FoCTow/ToolchangerDevelopment/README.md

# ToolchangerDevelopment
Overengineered 3D Printer Design
