FoCTow/ToolchangerDevelopment/PCB/Render/Back.jpg

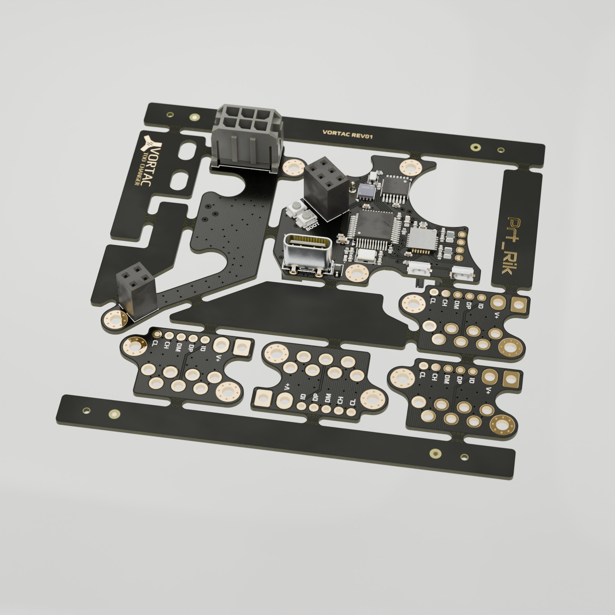
PCB/Render/Back.jpg
