FoCTow/ToolchangerDevelopment/PCB/Render/Front.jpg

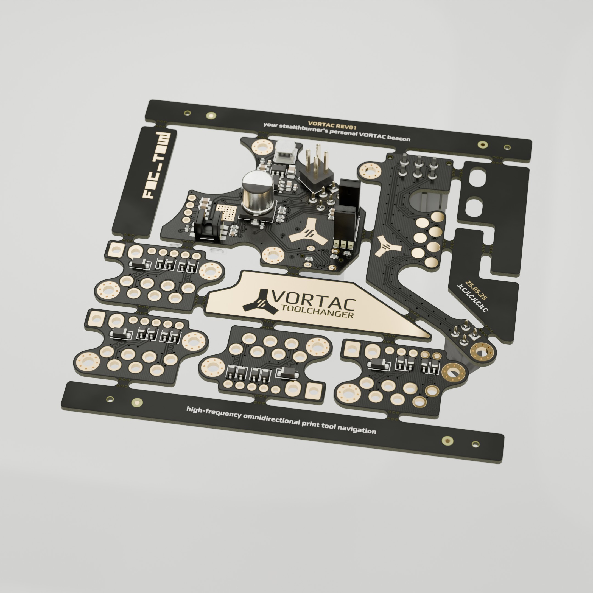
PCB/Render/Front.jpg
