FoCTow/ToolchangerDevelopment/PCB/Vectors/PCB  Main.dxf

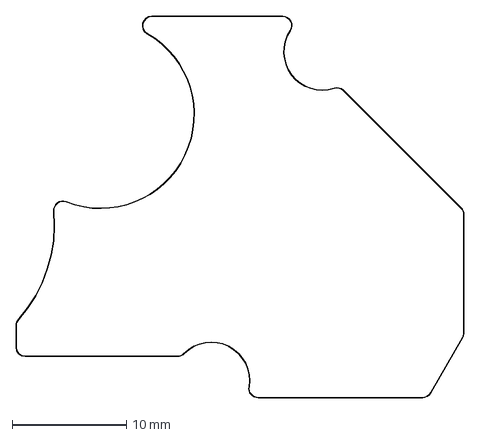
[picture p3: CAD file, 2025-05-24]
PCB/Vectors/PCB Main.dxf
39.2 x 33.4 mm
