FoCTow/ToolchangerDevelopment/PCB/Vectors/Vortac_Toolchanger_Logo.dxf

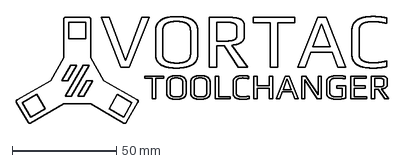
[picture p4: CAD file, 2025-05-25]
PCB/Vectors/Vortac_Toolchanger_Logo.dxf
178.7 x 51.4 mm
