FoCTow/ToolchangerDevelopment/PCB/VORTAC/KiCAD/VORTAC_PANEL/production/Panel_DXF.dxf

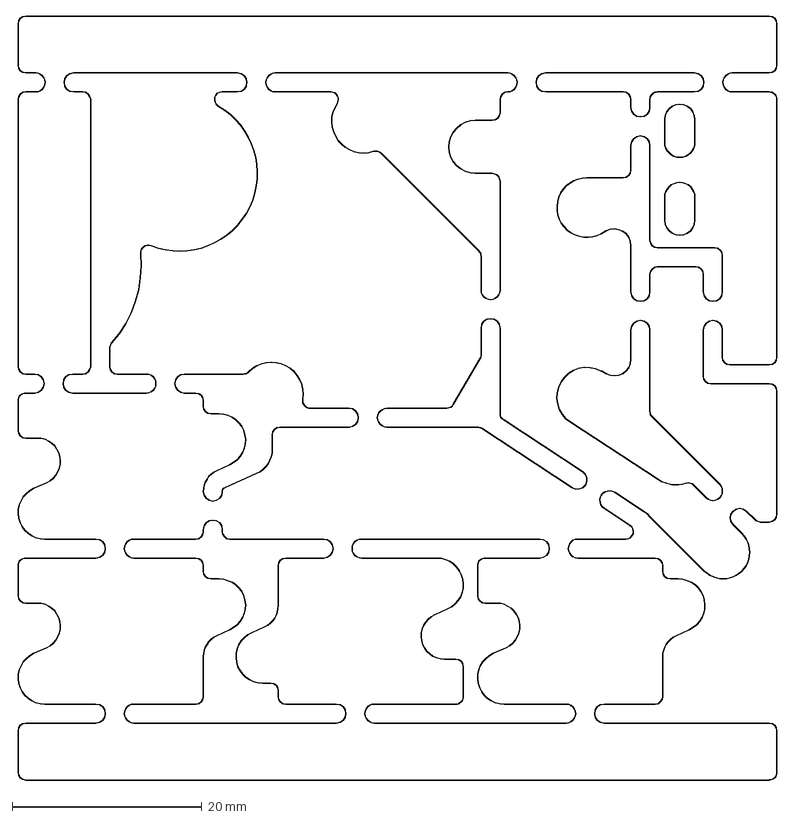
[picture p5: CAD file, 2025-05-25]
PCB/VORTAC/KiCAD/VORTAC_PANEL/production/Panel_DXF.dxf
80.2 x 80.6 mm
