FoCTow/ToolchangerDevelopment/PCB/VORTAC/KiCAD/VORTAC_TOOLPLATE_REV1/VORTAC_TOOLPLATE_REV1/VORTAC_TOOLPLATE_REV1.step

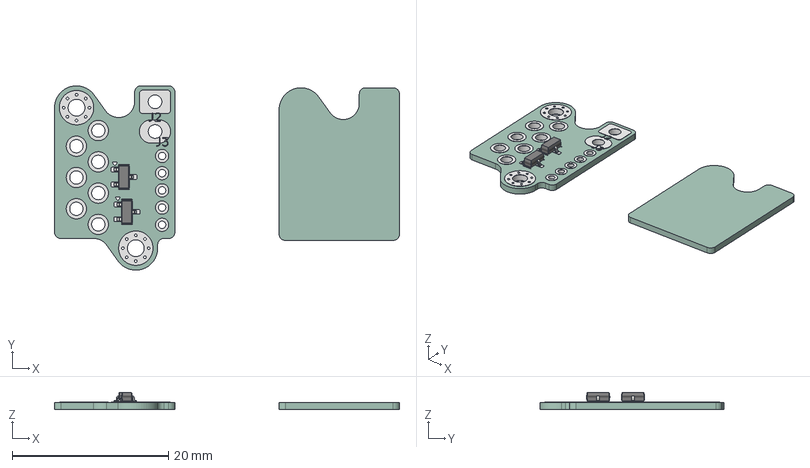
[picture p7: CAD file, 2025-05-24]
PCB/VORTAC/KiCAD/VORTAC_TOOLPLATE_REV1/VORTAC_TOOLPLATE_REV1/VORTAC_TOOLPLATE_REV1.step
44.1 x 23.6 x 2.23 mm
SOT-23 x 2
VORTAC_TOOLPLATE_REV1_pad
VORTAC_TOOLPLATE_REV1_silkscreen
VORTAC_TOOLPLATE_REV1_PCB_1
VORTAC_TOOLPLATE_REV1_PCB_2
