FoCTow/ToolchangerDevelopment/PCB/Vectors/PanelCenter.dxf

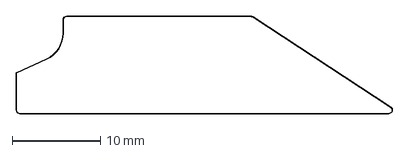
[picture p8: CAD file, 2025-05-25]
PCB/Vectors/PanelCenter.dxf
42.6 x 11.0 mm
