FoCTow/ToolchangerDevelopment/PCB/VORTAC/KiCAD/VORTAC_PANEL/production/Vortac_Panel_Rev1ToolBoardOnly.step

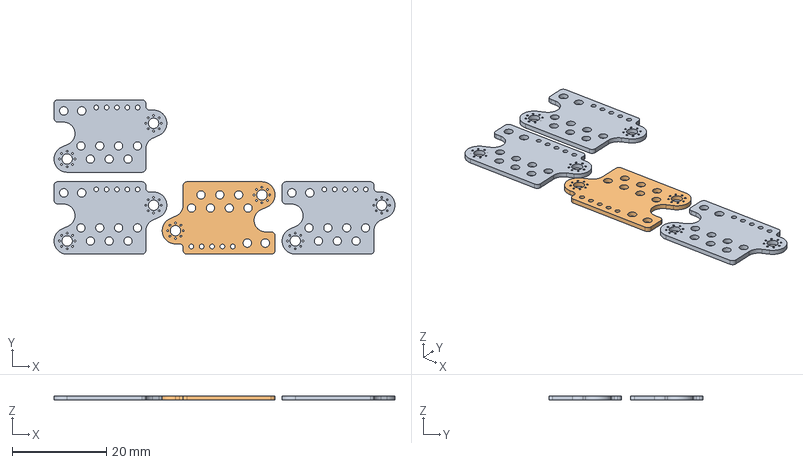
[picture p9: CAD file, 2025-05-25]
PCB/VORTAC/KiCAD/VORTAC_PANEL/production/Vortac_Panel_Rev1ToolBoardOnly.step
72.4 x 32.8 x 0.91 mm
Vortac_Panel_PCB_1
Vortac_Panel_PCB_2
Vortac_Panel_PCB_3
Vortac_Panel_PCB_4
