FoCTow/ToolchangerDevelopment/PCB/Vectors/PCB Tool.dxf

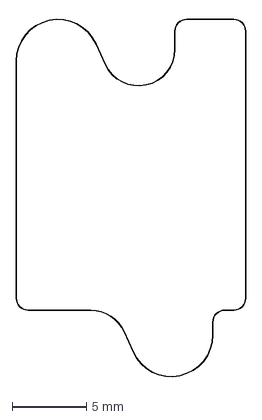
[picture p10: CAD file, 2025-05-24]
PCB/Vectors/PCB Tool.dxf
15.4 x 24.4 mm
