FoCTow/ToolchangerDevelopment/PCB/VORTAC/KiCAD/VORTAC_PANEL/production/Vortac_Panel_Rev1BoardOnly.step

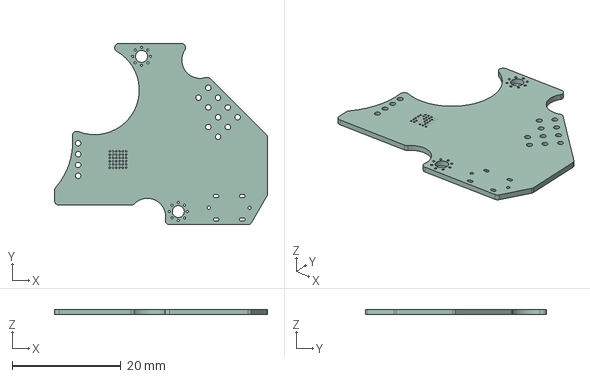
[picture p11: CAD file, 2025-05-25]
PCB/VORTAC/KiCAD/VORTAC_PANEL/production/Vortac_Panel_Rev1BoardOnly.step
39.2 x 33.4 x 0.91 mm
