FoCTow/ToolchangerDevelopment/PCB/VORTAC/KiCAD/VORTAC_PANEL/production/Vortac_Panel_TestPanel.step

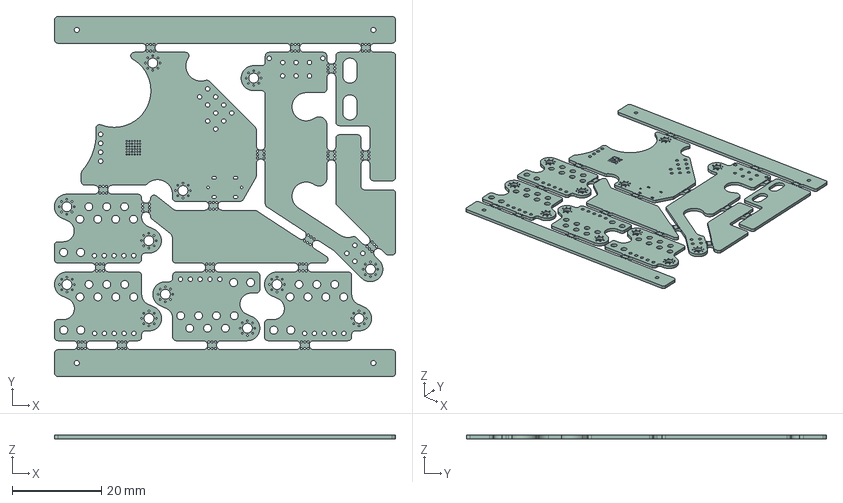
[picture p12: CAD file, 2025-05-25]
PCB/VORTAC/KiCAD/VORTAC_PANEL/production/Vortac_Panel_TestPanel.step
76.4 x 80.6 x 0.91 mm
