FoCTow/ToolchangerDevelopment/PCB/Vectors/PCB Front.dxf

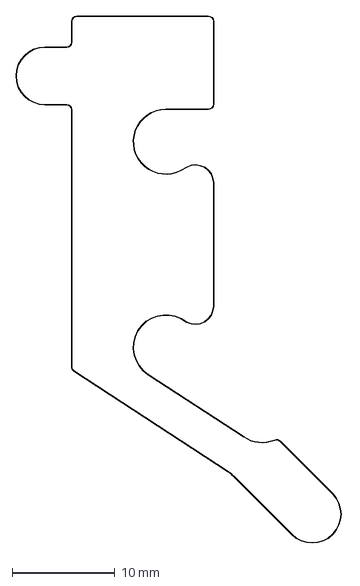
[picture p13: CAD file, 2025-05-24]
PCB/Vectors/PCB Front.dxf
31.9 x 51.5 mm
