FoCTow/ToolchangerDevelopment/PCB/VORTAC/KiCAD/VORTAC_PANEL/production/Vortac_Panel_export.step

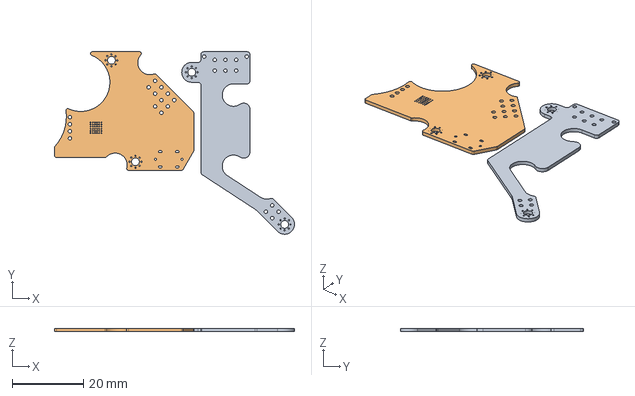
[picture p14: CAD file, 2025-05-23]
PCB/VORTAC/KiCAD/VORTAC_PANEL/production/Vortac_Panel_export.step
67.5 x 51.3 x 0.91 mm
Vortac_Panel_PCB_1
Vortac_Panel_PCB_2
