FoCTow/ToolchangerDevelopment/PCB/Vectors/PCB Clearance.dxf

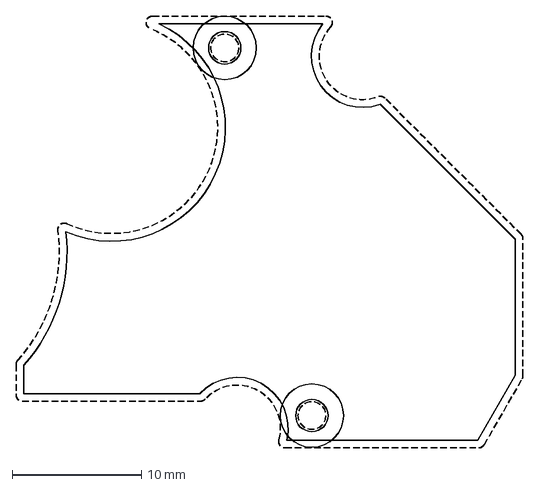
[picture p15: CAD file, 2025-05-21]
PCB/Vectors/PCB Clearance.dxf
39.2 x 33.4 mm
