FoCTow/ToolchangerDevelopment/(threads)

Thread 2 (2025-06-10):

Grabber PCB is missing 1.5K pullup on USB D+

FoCTow, 2025-06-10:
A 1.5K pull on usb d+ seems to be required to signal device connection, device speed and trigger address assignment.
The STM32f103 doesnt feature this internally so a 1.5K pullup on usb d+ is mandatory

Thread 3 (2025-06-10):

PCB power planes should have more edge clearance

FoCTow, 2025-06-10:
The Grabber PCB especially sits very close to the motors metal housing meaning a potential short could occur on the pcbs edge should printing tolerance expose the power plane to the side.
To remedy this the power planes edge clearance should be increased.
