FoCTow/ToolchangerDevelopment/PCB/VORTAC/KiCAD/VORTAC_TOOLPLATE_REV1/VORTAC_TOOLPLATE_REV1/VORTAC_TOOLPLATE_REV1.kicad_pcb

## KiCad design PCB/VORTAC/KiCAD/VORTAC_TOOLPLATE_REV1/VORTAC_TOOLPLATE_REV1/VORTAC_TOOLPLATE_REV1.kicad_pcb (2025-05-25)

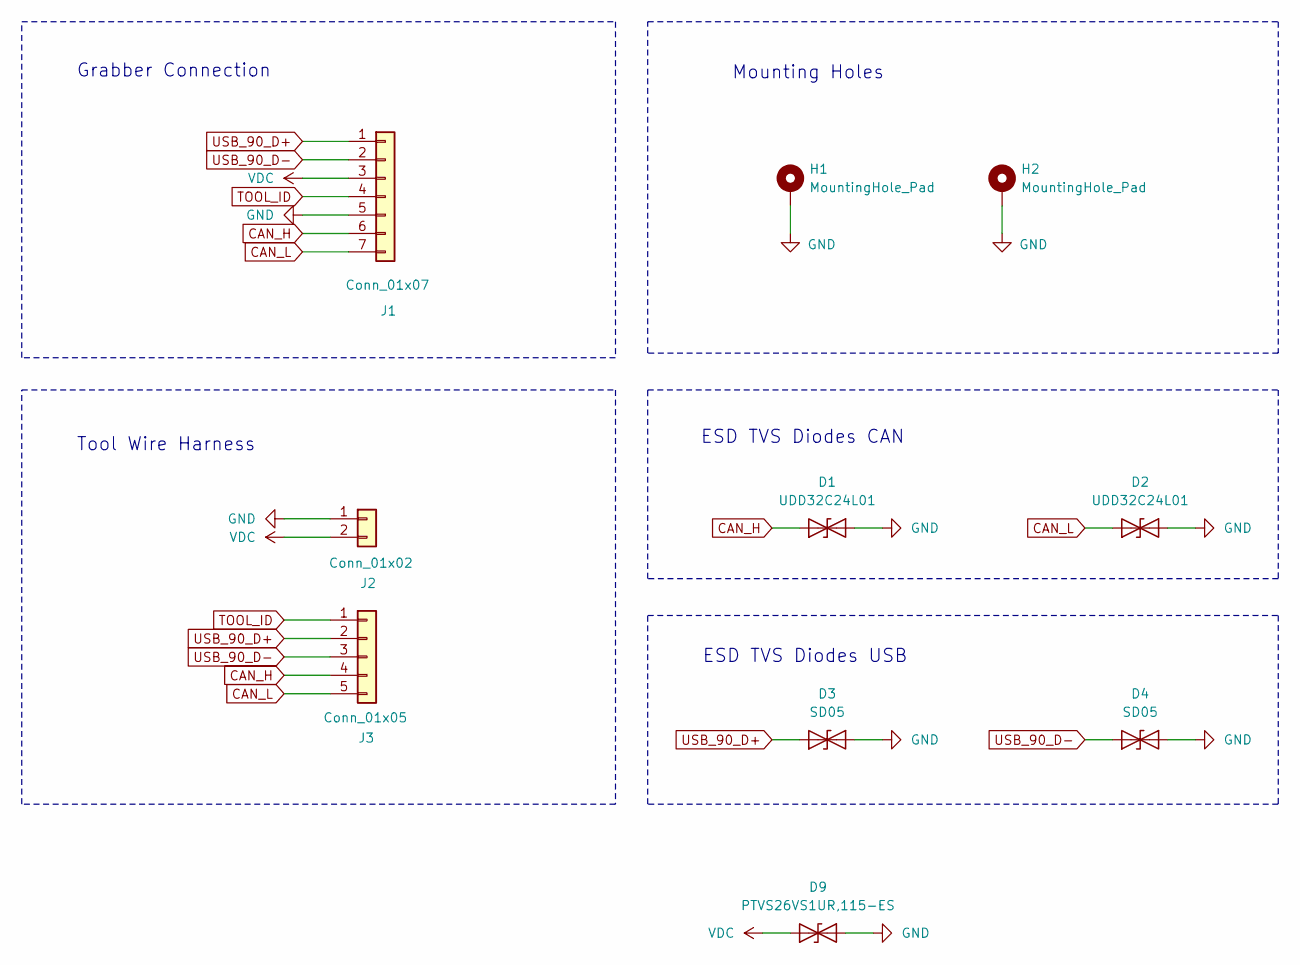
[picture p24: schematic VORTAC_TOOLPLATE_REV1.kicad_sch]

Parts:
D1, D2: UDD32C24L01; D_SOD-323; LCSC C19188728
D3, D4: SD05; D_SOD-323; LCSC C502527
D9: PTVS26VS1UR,115-ES; D_SOD-123F; LCSC C41409305
H1, H2: MountingHole_Pad; MountingHole_2.2mm_M2_Pad_Via_NTR
J1: Conn_01x07; mill-max-0881-1-15-20-82-14-11-0_LandingPads_ContactPad_PTH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
J2: Conn_01x02; Toolplate_Solderpoint_01x02_Power
J3: Conn_01x05; Toolplate_Solderpoint_01x05_Data

Connections:
CAN_H: D1.2 (A2), J1.6, J3.4
CAN_L: D2.2 (A2), J1.7, J3.5
GND: D1.1 (A1), D2.1 (A1), D3.1 (A1), D4.1 (A1), D9.1 (A1), H1.1, H2.1, J1.5, J2.1
TOOL_ID: J1.4, J3.1
USB_90_D+: D3.2 (A2), J1.1, J3.2
USB_90_D-: D4.2 (A2), J1.2, J3.3
VDC: D9.2 (A2), J1.3, J2.2

Notes on the sheet:
Grabber Connection
Tool Wire Harness
ESD TVS Diodes CAN
ESD TVS Diodes USB
Mounting Holes

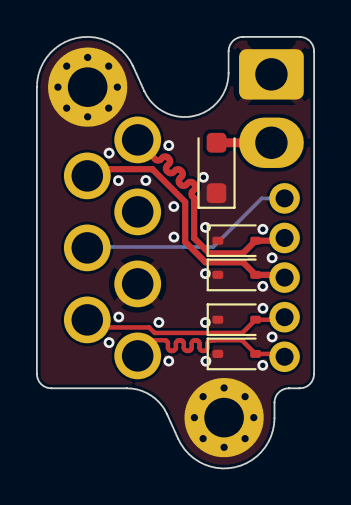
[picture p25: board VORTAC_TOOLPLATE_REV1.kicad_pcb from above]

Board: 4 copper layers, 15.4 x 24.0 mm, 10 parts (0 on the bottom side), 7 nets.
