FoCTow/ToolchangerDevelopment/PCB/VORTAC/KiCAD/VORTAC/VORTAC.kicad_pcb

## KiCad design PCB/VORTAC/KiCAD/VORTAC/VORTAC.kicad_pcb (2022-12-05, an earlier design)

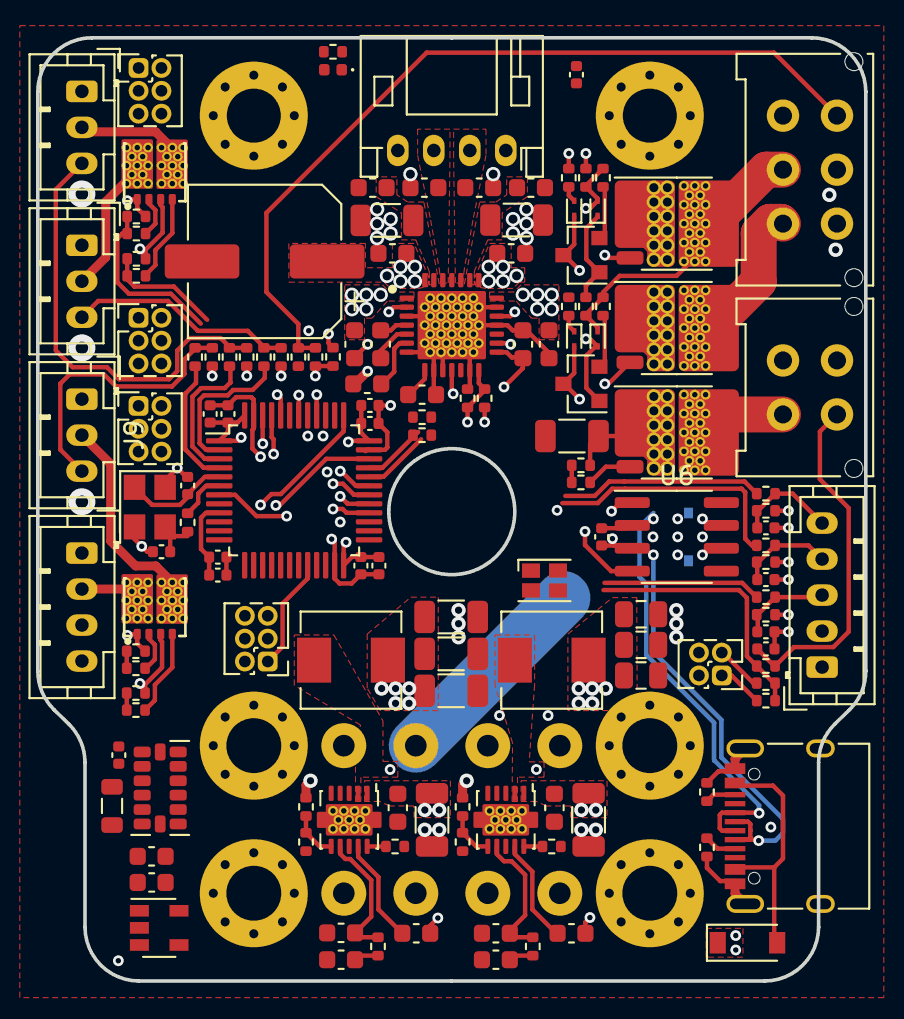
[picture p26: board VORTAC.kicad_pcb from above]

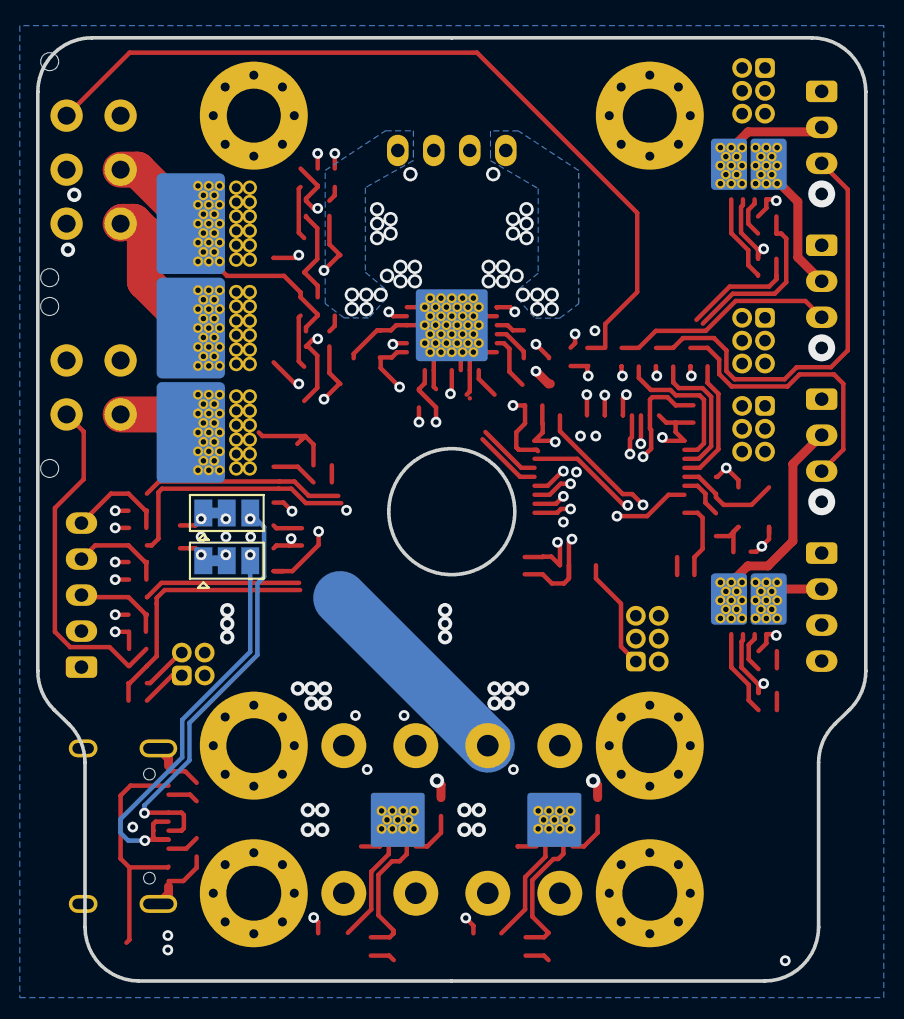
[picture p27: board VORTAC.kicad_pcb from below]

Board: 4 copper layers, 46.0 x 52.4 mm, 146 parts (4 on the bottom side), 107 nets.

Parts:
C1, C4, C5: 10uF 50V; C_1206_3216Metric
C2, C33, C35, C36, C37, C38, C39, C46, C47, C48, C49: 0.1uF 16V; C_0402_1005Metric
C3, C8: 1uF; C_0603_1608Metric
C6, C7, C9, C11, C21, C22, C24, C26, C29, C31, C41: 0.1uF 50V; C_0603_1608Metric
C10: 360pF; C_0603_1608Metric
C12: 3.3nF; C_0603_1608Metric
C13: 30pF; C_0603_1608Metric
C14: 56pF; C_0603_1608Metric
C15, C17, C19: 47uF; C_1206_3216Metric
C16, C18, C20: 47uF; C_0805_2012Metric
C23: 22nF X7R 10% 50V; C_0603_1608Metric
C25, C27, C28, C30: 470pF 100V; C_0603_1608Metric
C32, C40: 4.7uF 10V; C_0402_1005Metric
C34: 100uF 35V; CP_Elec_8x6.9
C42, C43: C_Small; C_0402_1005Metric
C44: 10nF; C_0402_1005Metric
C45: 1uF; C_0402_1005Metric
D1, D2, D3, D4: D; D_SOD-923
D5: D_Schottky; D_SOD-123
D6: LED_Small; LED_0402_1005Metric
D7: NeoPixel_THT; LED_Cree-PLCC4_2x2mm_CW
H1, H2: M3; MountingHole_3mm_Pad_Via
HSE1: 8MHz; Crystal_SMD_3225-4Pin_3.2x2.5mm
IC1: TMC2209-LA; tmc_2209_ThermalPad
J1: DEBUG; PinHeader_2x03_P1.27mm_Vertical
J2: Molex Micro Fit 3.0; Molex_Micro-Fit_3.0_43045-0612_2x03_P3.00mm_Vertical
J3, J4: MillMax_004; MillMax-858-10-004-10-012000
J5: USB_HOST; JST_PH_B4B-PH-K_1x04_P2.00mm_Vertical
J6: HOTEND; Molex_Micro-Fit_3.0_43045-0412_2x02_P3.00mm_Vertical
J7: FAN_01; JST_PH_B3B-PH-K_1x03_P2.00mm_Vertical
J8: FAN_02; JST_PH_B3B-PH-K_1x03_P2.00mm_Vertical
J9: LED; JST_PH_B3B-PH-K_1x03_P2.00mm_Vertical
J10: FAN_01_V; PinHeader_2x03_P1.27mm_Vertical
J11: FAN_02_V; PinHeader_2x03_P1.27mm_Vertical
J12: LED_V; PinHeader_2x03_P1.27mm_Vertical
J13: THERM_R; PinHeader_2x02_P1.27mm_Vertical
J14: 918-418K2023S40001; USB_C_Receptacle_XKB_U262-16XN-4BVC11
J15: STEPPER; JST_PH_S4B-PH-K_1x04_P2.00mm_Horizontal
J16: IO; JST_PH_B5B-PH-K_1x05_P2.00mm_Vertical
JP1: DATA_H JUMPER; SolderJumper-3_P1.3mm_Bridged12_Pad1.0x1.5mm
JP2: DATA_L JUMPER; SolderJumper-3_P1.3mm_Bridged12_Pad1.0x1.5mm
L1, L2: 10uH; L_Sunlord_MWSA0518_5.4x5.2mm
L3: 10uH 15mA; L_0805_2012Metric
Q1: Q_PMOS_GSD; IRF9310PbF-1_SO-8_ThermalPad
Q2, Q4: Q_NMOS_GSD; IRF9310PbF-1_SO-8_ThermalPad
Q3, Q5: WSD4066DN; WSD4066DN_ThermalPad
Q6: Q_PNP_BEC; SOT-23
Q7: Q_NPN_BEC; SOT-23
R1: 1K .1%; R_0402_1005Metric
R2: 4.7K .1%; R_0402_1005Metric
R3, R4: 5.12K; R_0402_1005Metric
R5, R6, R17, R18, R19, R20: 100K; R_0402_1005Metric
R7, R8, R9, R10, R11: 100R; R_0402_1005Metric
R12, R13, R14, R15, R16, R21, R39, R40, R41, R42, R43, R44, R45, R46, R47, R48, R49, R50, R51, R52: 10K; R_0402_1005Metric
R22: 36.5k; R_0402_1005Metric
R23: 10k; R_0402_1005Metric
R24, R25: 95k; R_0402_1005Metric
R26, R28: 100k; R_0402_1005Metric
R27: 7.15k; R_0402_1005Metric
R29: 19.1k; R_0402_1005Metric
R30, R34: 0.1R 1%; R_1206_3216Metric
R31: 1K; R_0402_1005Metric
R32, R33: 22K; R_0402_1005Metric
R35, R36: 22R; R_0402_1005Metric
R37, R38: R_Small; R_0402_1005Metric
U1: TLV73333PDBV; SOT-23-5
U2: STM32F103C8Tx; LQFP-48_7x7mm_P0.5mm
U3, U4: TPS54335ADRCR; VSON-10-1EP_3x3mm_P0.5mm_EP1.65x2.4mm_ThermalVias
U5: ADXL345BCCZ-RL; LGA-14_3x5mm_P0.8mm_LayoutBorder1x6y
U6: SN65HVD232DR; SOIC-8_3.9x4.9mm_P1.27mm

Connections:
+3.3VA: C44.1, C45.1, J13.2, J13.4, L3.2, U2.9
+3V3: C8.1, C21.1, C32.1, C33.2, C35.1, C36.2, C37.2, C38.2, C39.2, C40.2, IC1.15, J1.2, L3.1, R32.2, R45.1, R46.1, R47.1, R48.1, R49.1, R50.1, R52.1, U1.5, U2.1, U2.24, U2.36, U2.48, U5.1, U5.6, U6.3
+5V: C3.1, C16.1, C18.1, C20.1, D5.1, J5.1, J10.5, J11.5, J12.5, J16.1, L2.2, R28.1, U1.1, U1.3
+12V: C15.1, C17.1, C19.1, J10.3, J11.3, J12.3, L1.2, R26.1
ADXL_CS: U2.14, U5.7
ADXL_INT1: U2.13, U5.8
ADXL_SCL: U2.15, U5.14
ADXL_SDI: U2.17, U5.13
ADXL_SDO: U2.16, U5.12
BOOT_1: J1.1, U2.20
CAN_H: JP1.1, U6.7
CAN_L: JP2.1, U6.6
CAN_RX: U2.45, U6.4
CAN_TX: U2.46, U6.1
DEBUG_SWCLK: J1.6, U2.37
DEBUG_SWDIO: J1.5, U2.34
DOCK_GND: D4.2, J2.1, Q2.3, R18.2, R19.2
DOCK_VDC: D3.1, J2.2, Q1.3, R17.1, R20.1
FAN_1_DRAIN: J7.2, Q5.6
FAN_1_GATE: R10.2, R15.2, U2.42
FAN_1_TACHO: J7.3, R39.2, R45.2
FAN_1_V_OUT: J7.1, J10.2, J10.4, J10.6
FAN_2_DRAIN: J8.2, Q5.5
FAN_2_GATE: R9.2, R14.2, U2.43
FAN_2_TACHO: J8.3, R40.2, R46.2
FAN_2_V_OUT: J8.1, J11.2, J11.4, J11.6
GND: C1.2, C2.2, C3.2, C4.2, C5.2, C6.2, C7.2, C8.2, C10.2, C12.2, C13.2, C14.2, C15.2, C16.2, C17.2, C18.2, C19.2, C20.2, C21.2, C22.2, C25.1, C26.1, C27.1, C28.1, C29.1, C30.1, C31.1, C32.2, C33.1, C34.2, C35.2, C36.1, C37.1, C38.1, C39.1, C40.1, C41.1, C44.2, C45.2, C46.1, C47.1, C48.1, C49.1, D6.1, H1.1, H2.1, IC1.3, IC1.7, IC1.9, IC1.10, IC1.13, IC1.18, IC1.20, IC1.29, J1.4, J2.3, J3.1, J3.2, J4.1, J6.4, J14.A1, J14.A12, J14.B1, J14.B12, J14.S1, J16.2, Q2.2, Q3.1, Q3.3, Q4.2, Q5.1, Q5.3, R3.1, R4.1, R6.2, R12.1, R13.1, R14.1, R15.1, R16.1, R24.1, R25.1, R27.2, R29.2, R30.1, R33.2, R34.1, U1.2, U2.8, U2.23, U2.35, U2.47, U3.3, U3.4, U3.5, U3.11, U4.3, U4.4, U4.5, U4.11, U5.2, U5.4, U5.5, U6.2, U6.5, U6.8
GND1: C42.2, C43.2, HSE1.2, HSE1.4
HEATER_DRAIN: J6.1, Q4.3
HEATER_GATE: R11.2, R16.2, U2.27
HOST_USB_D+: J4.3, J5.3
HOST_USB_D-: J4.2, J5.4
HOST_USB_DRAIN: J5.2, Q3.5
HOST_USB_GATE: R7.2, R12.2, U2.10
HSE_OSC_IN: C42.1, HSE1.1, U2.5
HSE_OSC_OUT: R37.2, U2.6
IO_1_OUT: C46.2, J16.5, R42.2, R48.2
IO_1_OUT_PIN: R42.1, U2.26
IO_2_OUT: C47.2, J16.4, R43.2, R49.2
IO_2_OUT_PIN: R43.1, U2.25
IO_3_OUT: C48.2, J16.3, R44.2, R50.2
IO_3_OUT_PIN: R44.1, U2.22
LED_0: R38.2, U2.2
LED_1_DRAIN: J9.2, Q3.6
LED_1_GATE: R8.2, R13.2, U2.11
LED_1_PWM: J9.3, R41.2, R47.2
LED_1_V_OUT: J9.1, J12.2, J12.4, J12.6
NRST: J1.3, U2.7
unnamed: C9.1, L1.1, U3.2
unnamed: C9.2, U3.9
unnamed: C10.1, R22.2, U3.7
unnamed: C11.1, L2.1, U4.2
unnamed: C11.2, U4.9
unnamed: C12.1, R23.2, U4.7
unnamed: C13.1, R22.1
unnamed: C14.1, R23.1
unnamed: C22.1, IC1.8
unnamed: C23.1, IC1.5
unnamed: C23.2, IC1.4
unnamed: C24.1, IC1.6
unnamed: C43.1, HSE1.3, R37.1
unnamed: D1.1, Q1.1, Q7.3
unnamed: D1.2, R5.2
unnamed: D2.1, R6.1
unnamed: D2.2, Q2.1, Q6.3
unnamed: D3.2, Q6.1, R18.1
unnamed: D4.1, Q7.1, R20.2
unnamed: D5.2, J14.A4, J14.A9, J14.B4, J14.B9
unnamed: D6.2, R38.1
unnamed: J13.1, R1.1
unnamed: J13.3, R2.1
unnamed: J14.A5, R4.2
unnamed: J14.B5, R3.2
unnamed: Q3.2, R7.1
unnamed: Q3.4, R8.1
unnamed: Q4.1, R11.1
unnamed: Q5.2, R9.1
unnamed: Q5.4, R10.1
unnamed: Q6.2, R17.2
unnamed: Q7.2, R19.1
unnamed: R24.2, U3.10
unnamed: R25.2, U4.10
unnamed: R26.2, R27.1, U3.6
unnamed: R28.2, R29.1, U4.6
unnamed: R35.2, U2.32
unnamed: R36.2, U2.33
STEP_1_A1: C28.2, IC1.24, J15.2
STEP_1_A2: C30.2, IC1.21, J15.1
STEP_1_B1: C27.2, IC1.26, J15.3
STEP_1_B2: C25.2, IC1.1, J15.4
THERM_1_OUT: C2.1, J6.3, R21.1
THERM_1_PIN: R1.2, R2.2, R21.2, U2.21
TMC_BRA: C41.2, IC1.23, R34.2
TMC_BRB: C31.2, IC1.27, R30.2
TMC_DIAG: IC1.11, U2.38
TMC_DIR: IC1.19, U2.29
TMC_ENN: IC1.2, R32.1, U2.40
TMC_STEP: IC1.16, U2.28
TMC_UART_RX: IC1.14, R31.2, R33.1, U2.31
TMC_UART_TX: R31.1, U2.30
TOOL_DATA_H: J2.5, J3.4, JP1.2
TOOL_DATA_L: J2.4, J3.5, JP2.2
TOOL_ID: C49.2, J2.6, J4.4, R51.2, R52.2
TOOL_ID_PIN: R51.1, U2.41
USB_D+: J14.A6, J14.B6, JP1.3, R36.1
USB_D-: J14.A7, J14.B7, JP2.3, R35.1
VDC: C1.1, C4.1, C5.1, C6.1, C7.1, C24.2, C26.2, C29.2, C34.1, IC1.22, IC1.28, J3.3, J6.2, J10.1, J11.1, J12.1, Q1.2, R5.1, U3.1, U4.1
