FoCTow/ToolchangerDevelopment/PCB/STM32CubeMX/STM32CubeMX.ioc

Mcu.UserName=STM32F103C8Tx
PA0-WKUP.GPIO_Label=GPIO_OUT_TMC_ENN
PA0-WKUP.Signal=GPIO_Output
PA1.GPIO_Label=GPIO_OUT_TMC_DIR
PA1.Signal=GPIO_Output
PA11.Signal=USB_DM
PA12.Signal=USB_DP
PA13.Signal=SYS_JTMS-SWDIO
PA14.Signal=SYS_JTCK-SWCLK
PA2.Signal=USART2_TX
PA3.GPIO_Label=TIM2_CH4_TMC_STEP
PA3.Signal=S_TIM2_CH4
PA9.Signal=USART1_TX
PB0.GPIO_Label=GPIO_IN_TMC_DIAG
PB0.Signal=GPIO_Input
PB12.Signal=SPI2_NSS
PB13.Signal=SPI2_SCK
PB14.Signal=SPI2_MISO
PB15.Signal=SPI2_MOSI
PB3.Signal=SYS_JTDO-TRACESWO
PB8.Signal=CAN_RX
PB9.Signal=CAN_TX
PD0-OSC_IN.Signal=RCC_OSC_IN
PD1-OSC_OUT.Signal=RCC_OSC_OUT
