FoCTow/ToolchangerDevelopment/(commit log)

2021-09-11 Added Step Files for Spring Loaded MillMax Connectors
2021-09-12 Updated PCB Schematic
    [Headers.sch, Logic.sch, MCU.sch]
2021-09-22 pcb, step and headers
    -headers schematic updated
    -created rough pcb placement of headers
    -created step file for inspection in fusion 360
    [Headers.sch, MCU.sch, PANEL_TEST.csv, PANEL_TEST.kicad_pcb, PANEL_TEST.sch, VORTAC.kicad_pcb, VORTAC.sch]
2021-09-22 footprints and libs
    [VORTAC.kicad_pcb]
2021-09-22 Auto stash before merge of "main" and "origin/main"
    [Headers.sch, Logic.sch]
2021-09-23 updated schematics
    [Headers.sch, Logic.sch]
2021-09-23 TMC and Acc preperation
    [Logic.sch]
2021-10-02 GitIgnore and Footprints
    [Logic.sch]
2021-10-03 Schematic and Lib Updates
    [Headers.sch, Logic.sch, MCU.sch, VORTAC.kicad_pcb]
2021-10-13 pushie
    updates and stuff
    [Headers.sch, Logic.sch, MCU.sch, VORTAC.kicad_pcb]
2021-10-23 Layouting & Footprints
    -Improved Thermal Footprint Conductivity
    -Improved Component Spacing
    [Headers.sch, Logic.sch, MCU.sch, VORTAC.kicad_pcb]
2021-10-24 IT l0oks like a Face FML =/
    thanks henny
    [MCU.sch, VORTAC.kicad_pcb]
2021-11-11 Routing WIP
    [Headers.sch, Logic.sch, MCU.sch, VORTAC.kicad_pcb, VORTAC_Backup.kicad_pcb, VORTAC_trihole.kicad_pcb]
2021-11-11 Reversed voltage selectors to simplify routing
    [Headers.sch, VORTAC.kicad_pcb]
2021-11-17 More Routing
    [Headers.sch, MCU.sch, VORTAC.kicad_pcb, VORTAC_Backup.kicad_pcb]
2021-11-21 Still Routing
    [MCU.sch, VORTAC.kicad_pcb]
2021-11-21 Added Protective Passives
    [Logic.sch, MCU.sch, VORTAC.kicad_pcb]
2021-11-21 Holiday Break <3
    [Logic.sch, MCU.sch, VORTAC.kicad_pcb]
2021-12-10 Uppodateo des
    [MCU.sch, VORTAC.kicad_pcb]
2024-08-16 Just fucking everything cause git doesnt sort shit
    [Headers.kicad_sch, Headers.sch, Logic.kicad_sch, Logic.sch, MCU.kicad_sch, MCU.sch, VORTAC.kicad_sch, VORTAC_Backup.kicad_pcb]
2024-08-16 Init Vortac_rev1
    [Headers.kicad_sch, Headers.sch, Logic.kicad_sch, Logic.sch, MCU.kicad_sch, MCU.sch, VORTAC_Backup.kicad_pcb, VORTAC_REV1.kicad_pcb]
2025-04-26 Added New EE_SX3350
    [Headers.kicad_sch, Logic.kicad_sch, MCU.kicad_sch, VORTAC_REV1.kicad_pcb, VORTAC_REV1.kicad_sch]
2025-04-28 added new usb
    [Headers.kicad_sch, MCU.kicad_sch, VORTAC_REV1.kicad_pcb]
2025-04-29 Fixed Library stuff
    [Headers.kicad_sch, Logic.kicad_sch, MCU.kicad_sch, VORTAC_REV1.kicad_pcb, VORTAC_REV1.kicad_sch]
2025-04-29 changed Button Path
2025-04-29 pls merge Jenno
    [Headers.kicad_sch, Logic.kicad_sch, MCU.kicad_sch, VORTAC_REV1.kicad_pcb, VORTAC_REV1.kicad_sch]
2025-04-29 changed usb header
    [Headers.kicad_sch]
2025-04-29 Liebe Griasse zurrueck
    [Headers.kicad_sch, Logic.kicad_sch, MCU.kicad_sch, VORTAC_REV1.kicad_pcb]
2025-05-04 Schematic updates
    [Headers.kicad_sch, Logic.kicad_sch, VORTAC_REV1.kicad_pcb]
2025-05-04 Added LED-SMD
2025-05-04 Led Symbol Hand Wire footprint
2025-05-04 Schematic Updates - Changed the 5V Rail to a more space efficient implementation
    [Headers.kicad_sch, Logic.kicad_sch, MCU.kicad_sch, VORTAC_REV1.kicad_pcb]
2025-05-05 Schematic Updates Madrilla
    [Logic.kicad_sch, MCU.kicad_sch, VORTAC_REV1.kicad_pcb]
2025-05-05 update to Kicad 9.0.X
    [Headers.kicad_sch, Logic.kicad_sch, MCU.kicad_sch, VORTAC_REV1.kicad_pcb, VORTAC_REV1.kicad_sch]
2025-05-05 Update Symbol Librarys
    [Headers.kicad_sch, Logic.kicad_sch, MCU.kicad_sch]
2025-05-05 updated tmc library reference
    [MCU.kicad_sch]
2025-05-05 updated revs fabrication test
    [Headers.kicad_sch, Logic.kicad_sch]
2025-05-05 added mosfet
2025-05-05 night night
    [Headers.kicad_sch, Logic.kicad_sch, MCU.kicad_sch, VORTAC_REV1.kicad_pcb, VORTAC_REV1.kicad_sch]
2025-05-12 Anned Parts
    [Headers.kicad_sch, Logic.kicad_sch, MCU.kicad_sch]
2025-05-16 Evil Mita is v00:98
    [Headers.kicad_sch, Logic.kicad_sch, MCU.kicad_sch, VORTAC_FRONT_REV1.kicad_pcb, VORTAC_FRONT_REV1.kicad_sch, VORTAC_REV1.kicad_pcb]
2025-05-18 No Body knows.... The trouble I've seen
    [Headers.kicad_sch, Logic.kicad_sch, MCU.kicad_sch, VORTAC_FRONT_REV1.kicad_pcb, VORTAC_FRONT_REV1.kicad_sch, VORTAC_REV1.kicad_pcb, Vortac_Panel.kicad_pcb]
2025-05-19 Nobody knows, my Sorrow...
    [VORTAC_REV1.kicad_pcb]
2025-05-20 Girl Math
    [Headers.kicad_sch, Logic.kicad_sch, VORTAC_REV1.kicad_pcb, Vortac_Logo.dxf]
2025-05-21 Route me like one of you French girls
    [Headers.kicad_sch, Logic.kicad_sch, MCU.kicad_sch, PCB Clearance.dxf, VORTAC_REV1.kicad_pcb]
2025-05-22 USB C Pain
    [Headers.kicad_sch, MCU.kicad_sch, VORTAC_REV1.kicad_pcb]
2025-05-22 USB C Survivor
    [VORTAC_FRONT_REV1.kicad_pcb, VORTAC_REV1.kicad_pcb]
2025-05-23 On the Grind
    [VORTAC_REV1.kicad_pcb]
2025-05-23 I NEED A HEEEROOO
    [Logic.kicad_sch, VORTAC_REV1.kicad_pcb]
2025-05-23 Tiny Tweaks
    [VORTAC_REV1.kicad_pcb]
2025-05-23 Moved Panel Project and added Panel
    [Panel_DXF.dxf, Vortac_Panel.kicad_pcb, Vortac_Panel.kicad_sch, Vortac_Panel_export.step]
2025-05-24 Tool can has pcb pls
    [PCB Main.dxf, PCB Front.dxf, PCB Tool.dxf, VORTAC_REV1.kicad_pcb, VORTAC_TOOLPLATE_REV1.kicad_pcb, VORTAC_TOOLPLATE_REV1.kicad_sch, VORTAC_TOOLPLATE_REV1.step]
2025-05-24 MEIN BEEEEEIIIINNNN
    [PCB Tool.dxf, VORTAC_REV1.kicad_pcb, VORTAC_TOOLPLATE_REV1.kicad_pcb, VORTAC_TOOLPLATE_REV1.kicad_sch, VORTAC_TOOLPLATE_REV1.step]
2025-05-25 Panel Progress
    [Panel_DXF.dxf, Vortac_Panel.kicad_pcb, Vortac_Panel_Rev1BoardOnly.step, Vortac_Panel_Rev1ToolBoardOnly.step, Vortac_Panel_TestPanel.step]
2025-05-25 added missing R
    [MCU.kicad_sch]
2025-05-25 updated Outlines
    [Panel_DXF.dxf, Vortac_Panel.kicad_pcb, Vortac_Panel_Rev1ToolBoardOnly.step]
2025-05-25 Panel Center 1mm offset
    [PanelCenter.dxf]
2025-05-25 Logo Vector Panel Updates Logo Footprint Test
    [Vortac_Panel.kicad_pcb]
2025-05-25 updated Panel
    [VORTAC_REV1.kicad_pcb, Vortac_Panel.kicad_pcb]
